benlorenzetti/Potentiostat-Sensor_Interface_Hardware/Report/report.pdf

# Potentiostat Hardware for USB-Style Sensors

Ben Lorenzetti, BioMicroSystems Laboratory

A

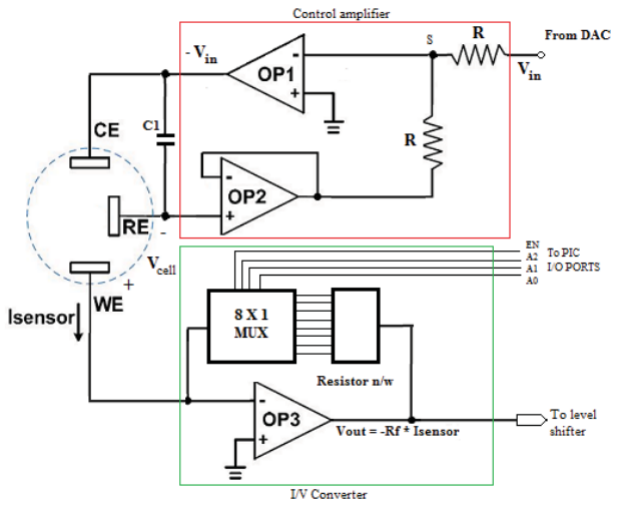
[picture p7: figure]

portable measurement system was assembled using a commercial potentiostat, a custom circuit board, and a 3D-printed enclosure. The system will help demonstrate the portability and simplicity the electrochemical sensors being developed in BioMicroSystems Lab.

## Introduction

BioMicroSystems (BMS) Lab is developing pointof-care electrochemical sensors for measuring heavy metal concentrations in environmental samples, such as manganese in lake water [?].


Figure 1: Measuring Manganese [?]

Three electrodes are inundated in a sample and a potential is applied between two of the electrodes, while a different pair of two electrodes is used to measure current. At some applied voltage, an oxidationreduction reaction occurs between the metal of interest and the working electrode surface. Charge is emitted as the metal changing oxidation state; so measuring and integrating the current gives the quantity of metal reagent in the sample.
In a three electrode system, one electrode must be common to both the voltage pair and the current pair, and this is termed the counter electrode. For the other two electrodes (reference and working) to accurately separate voltage and current, they must be virtually grounded by amplifier electronics. A device which drives the virtual ground, sets a potential, and measures resulting current is called a potentiostat.

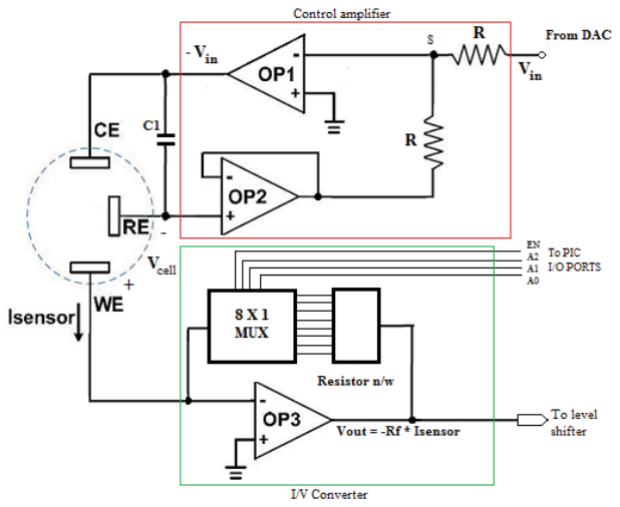
[picture p8: figure]

Figure 2: Op-Amp Potentiostat [?]

The possible advantages of the point-of-care electrodes being developed by BMS Lab include low cost, portability, measurement speed, and simplicity for non-technical operators. To realize these advantages, a small, portable potentiostat is needed with a simple user interface.

(a) EmStat Potentiostat | (b) Pinout Diagram

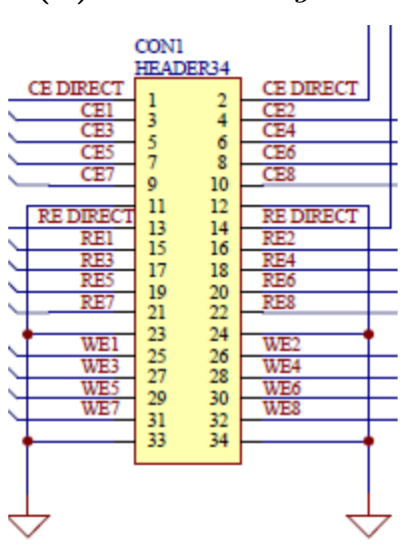
[picture p9: figure]
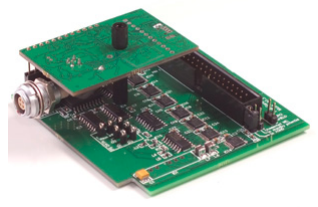
[picture p10: figure]

(c) EmStat with Multiplexer | (d) Pinout Schematic

Figure 3: EmStat and Multiplexer from PalmSens [?]

## Method

An OEM potentiostat board measuring only 2” x 1.35” was purchased from PalmSens, called EmStat. Also from PalmSens, a Multiplexer was purchased that allows EmStat to switch between multiple sensors. The EmStat–Multiplexer connection and the external interface towards the sensors are shown in figure 3.
The external interface from the Multiplexer is a standard 0.1” header but the sensors are made to be inserted into a USB receptacle. To make this simple for the end user, a custom breakout board was made to fit in the space between the EmStat and Multiplexer boards.
The breakout board was designed in CadSoft Eagle and the .brd file was sent to OSH Park LLC for manufacture. The Eagle project and part libraries used can be found in the directory PCB Boards/. In addition to the manufactured board, the components listed in table 2 are need for assembly.

Table 1: Breakout Board Components

Qty. | Component | Man. Part #
4 | USB type-A receptacle | 292303-1
1 | USB mini receptacle | 0548190519
1 | USB mini plug kit | 1734205-1
1 | 34-pin, 0.1” header | SFH11-PBPC-D17-ST-BK
| hookup wire and heat shrink
| for USB plug kit

The x-y coordinates used in aligning the EmStat, Multiplexer, and breakout board are shown in appendix ??. The schematic diagram for the breakout board and a transparent view from Eagle are incluced

(a) Breakout Board | (b) PCB Sandwich...tasty

Figure 4: Breakout Board for EmStat/MUX

in appendix ??.
The packaging was designed in SolidWorks to be 3D-printed in two parts: a base and a lid. In addition to the base and lid, six size #3-48, 1.25” long machine screws and #3-48 tapping equipment are needed for assembly. Instructions for tapping can be found in appendix ??.

Table 2: Assembly Components

Qty. | Component | McMaster Part #
6 | 3-48, 1.25” socket head cap screws | 90044A243
3-48 tap, tap driver, and spring
loaded tap guide | appendix ??

The design of the packaging was tested and iterated in house using a Makerobt Replicator 2X with ABS filament. Mechanical drawings of the base and lid and a list of revisions are included in appendix ??. For printing with MakerBot or an outside printing house, the files Enclosure Base.STL
and | Enclosure Lid.STL | are | needed | from
the Packaging/ directory. | For editing the
parts, the SolidWorks files are located in the Packaging/SolidWorks Files subdirectory.
In addition to the potentiostat system, three small sensor interface boards were built. One allows a USB-style sensor to be extended away from the potentiostat system by a USB male-A-to-male-mini cable. Another allows USB-style sensors to be easily connected to the WaveNow potentiostat. The third allows USB-style sensors to be connected to aligator clips for electroplating, etc.
Designs for these three interface boards are included in appendix ??.

## 1 Results

Sed commodo posuere pede. Mauris ut est. Ut quis purus. Sed ac odio. Sed vehicula hendrerit sem. Duis non odio. Morbi ut dui. Sed accumsan risus eget odio. In hac habitasse platea dictumst. Pellentesque non

Table 3: Random table

Name

First name | Last Name | Grade
John | Doe | 7.5
Richard | Miles | 2

elit. Fusce sed justo eu urna porta tincidunt. Mauris felis odio, sollicitudin sed, volutpat a, ornare ac, erat. Morbi quis dolor. Donec pellentesque, erat ac sagittis semper, nunc dui lobortis purus, quis congue purus metus ultricies tellus. Proin et quam. Class aptent taciti sociosqu ad litora torquent per conubia nostra, per inceptos hymenaeos. Praesent sapien turpis, fermentum vel, eleifend faucibus, vehicula eu, lacus.

## Section 2

Pellentesque habitant morbi tristique senectus et netus et malesuada fames ac turpis egestas. Donec odio elit, dictum in, hendrerit sit amet, egestas sed, leo. Praesent feugiat sapien aliquet odio. Integer vitae justo. Aliquam vestibulum fringilla lorem. Sed neque lectus, consectetuer at, consectetuer sed, eleifend ac, lectus. Nulla facilisi. Pellentesque eget lectus. Proin eu metus. Sed porttitor. In hac habitasse platea dictumst. Suspendisse eu lectus. Ut mi mi, lacinia sit amet, placerat et, mollis vitae, dui. Sed ante tellus, tristique ut, iaculis eu, malesuada ac, dui. Mauris nibh leo, facilisis non, adipiscing quis, ultrices a, dui.

First This is the first item

Last This is the last item

Morbi luctus, wisi viverra faucibus pretium, nibh est placerat odio, nec commodo wisi enim eget quam. Quisque libero justo, consectetuer a, feugiat vitae, porttitor eu, libero. Suspendisse sed mauris vitae elit sollicitudin malesuada. Maecenas ultricies eros sit amet ante. Ut venenatis velit. Maecenas sed mi eget dui varius euismod. Phasellus aliquet volutpat odio. Vestibulum ante ipsum primis in faucibus orci luctus et ultrices posuere cubilia Curae; Pellentesque sit amet pede ac sem eleifend consectetuer. Nullam elementum, urna vel imperdiet sodales, elit ipsum pharetra ligula, ac pretium ante justo a nulla. Curabitur tristique arcu eu metus. Vestibulum lectus. Proin mauris. Proin eu nunc eu urna hendrerit faucibus. Aliquam auctor, pede consequat laoreet varius, eros tellus scelerisque quam, pellentesque hendrerit ipsum dolor sed augue. Nulla nec lacus.

## References

[Figueredo and Wolf, 2009] Figueredo, A. J. and Wolf, P. S. A. (2009). Assortative pairing and life history strategy - a cross-cultural study. Human Nature, 20:317–330.
