benlorenzetti/Potentiostat-Sensor_Interface_Hardware/Report/All_PDFs_to_Merge/top-view.pdf

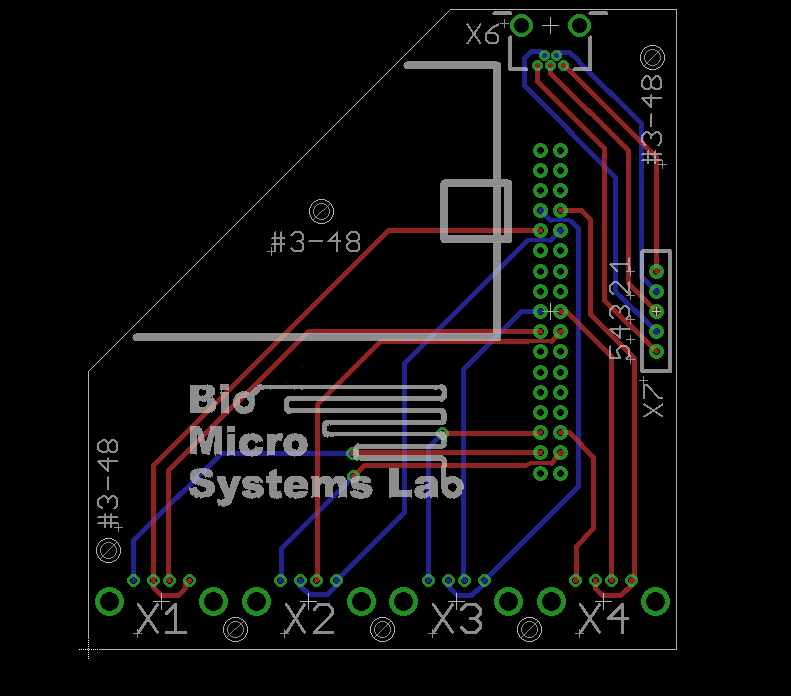
[picture p11: figure]

Transparent, top-side view of Breakout Board
