benlorenzetti/Potentiostat-Sensor_Interface_Hardware/Report/All_PDFs_to_Merge/2015-04-14-Enclosure-Base.pdf

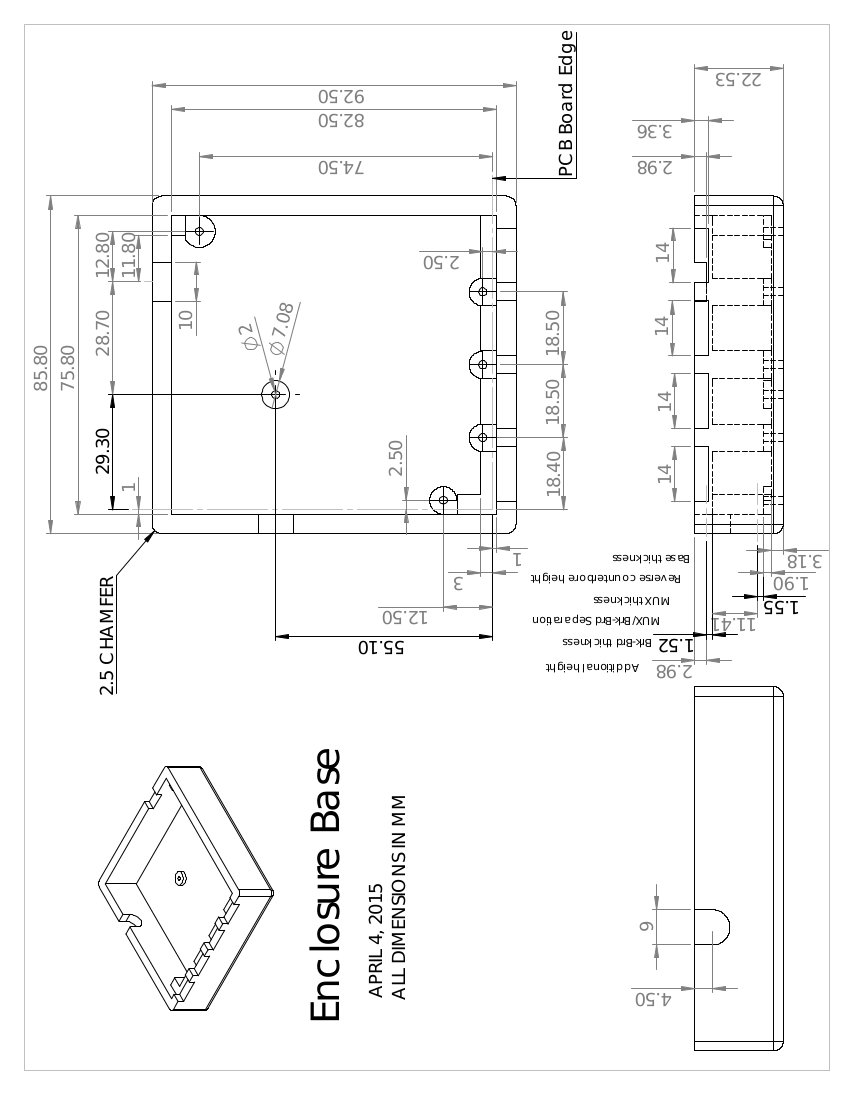
[picture p12: page 1]
