benlorenzetti/Potentiostat-Sensor_Interface_Hardware/Report/Figures/sensor-enclosure-bottom.pdf

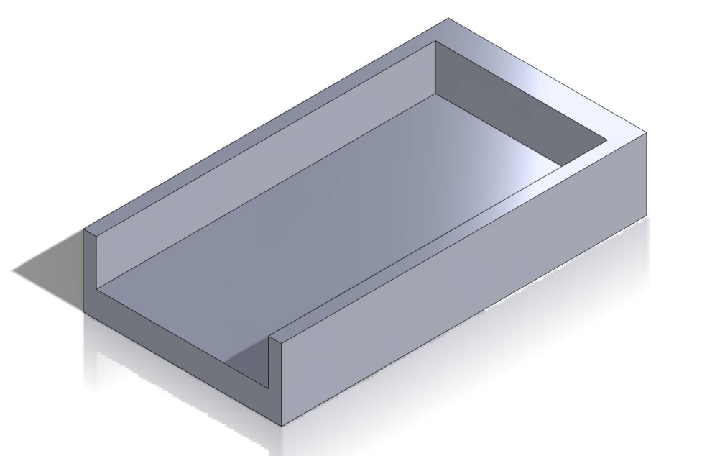
[picture p13: page 1]
