benlorenzetti/Potentiostat-Sensor_Interface_Hardware/Report/Figures/sensor-enclosure-top.pdf

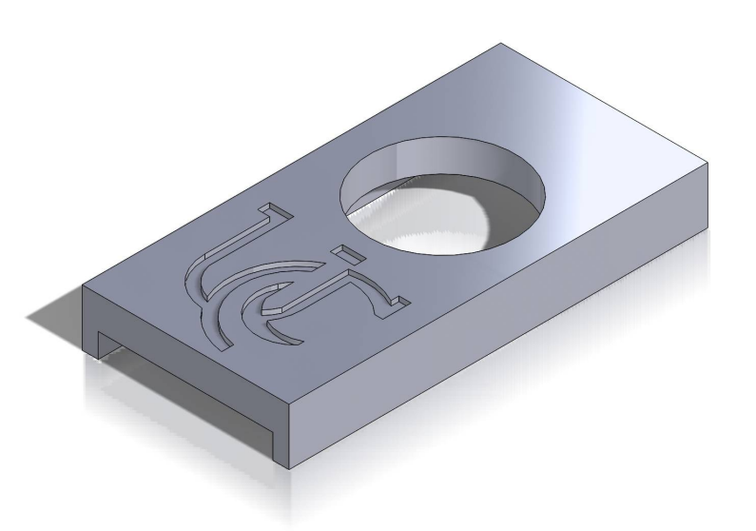
[picture p14: page 1]
