benlorenzetti/Potentiostat-Sensor_Interface_Hardware/Report/Figures/breakout-board.pdf

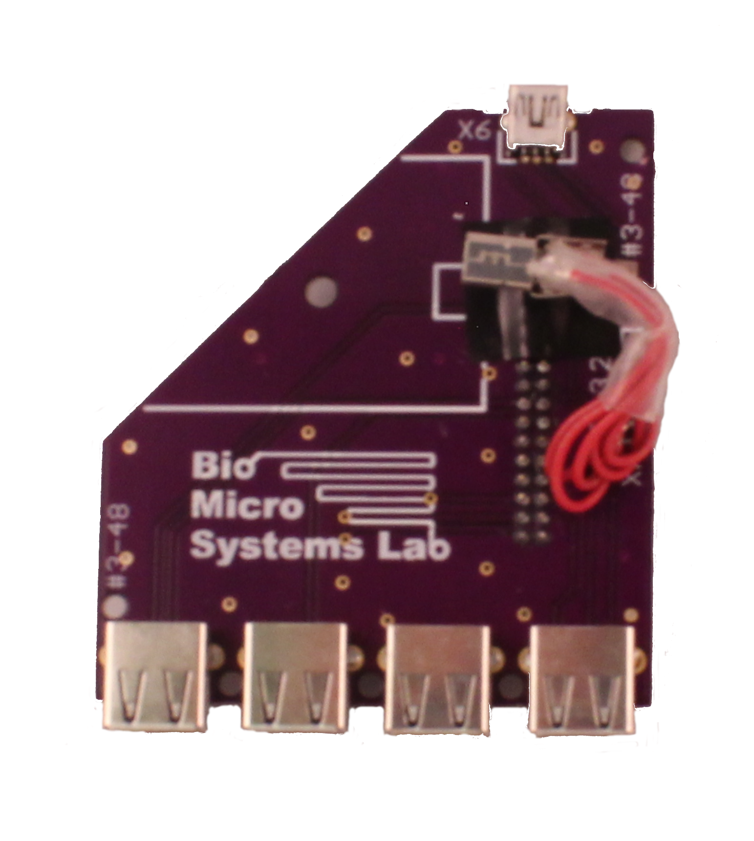
[picture p15: page 1]
