benlorenzetti/Potentiostat-Sensor_Interface_Hardware/Report/Figures/interface-board.pdf

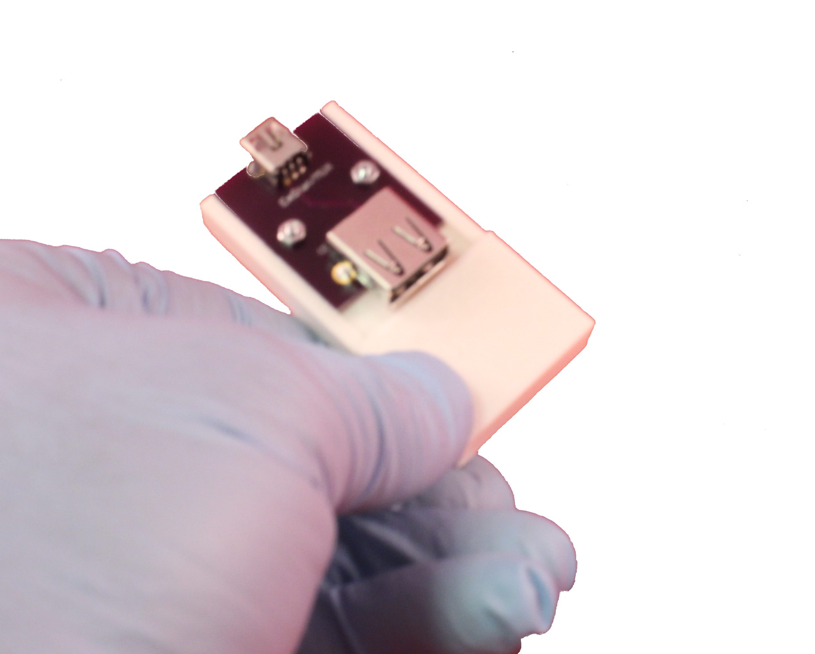
[picture p16: page 1]
