benlorenzetti/Potentiostat-Sensor_Interface_Hardware/Report/Figures/packaging-comparison.pdf

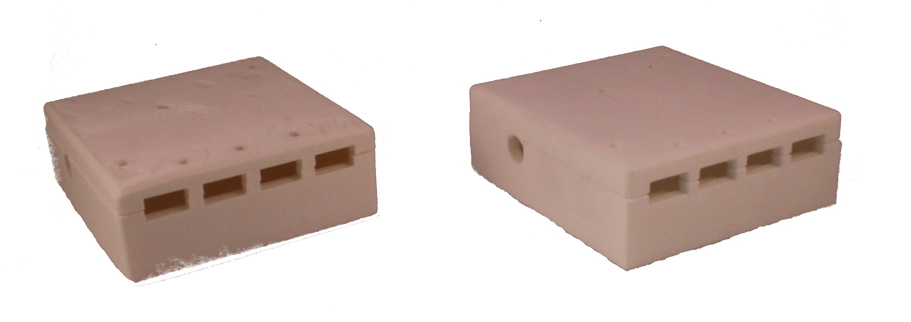
[picture p17: page 1]
