benlorenzetti/Potentiostat-Sensor_Interface_Hardware/Report/Figures/tap-location-drawing.pdf

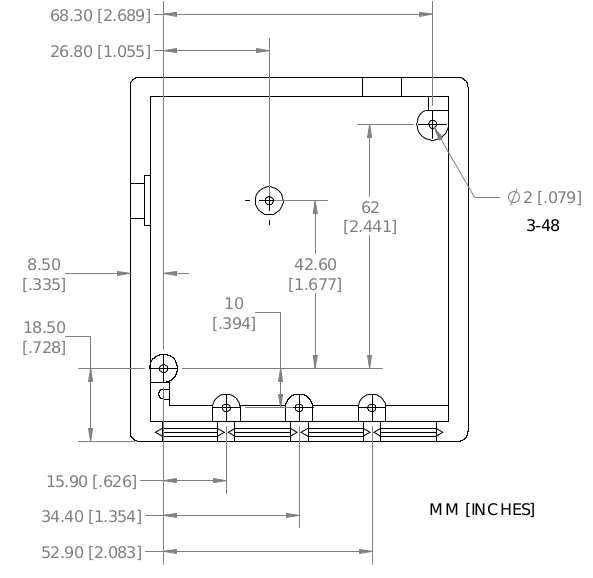
[picture p18: page 1]
