benlorenzetti/Potentiostat-Sensor_Interface_Hardware/Report/Figures/zinc-paper-potentiostat.pdf

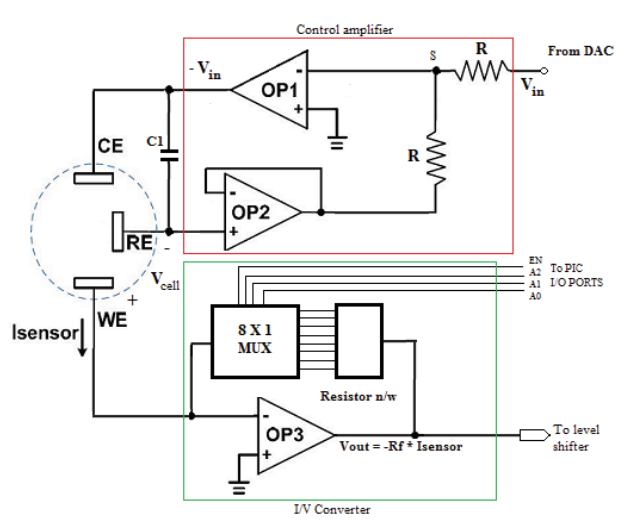
[picture p19: page 1]
