benlorenzetti/Potentiostat-Sensor_Interface_Hardware/Report/Figures/setting_eagle_directories.png

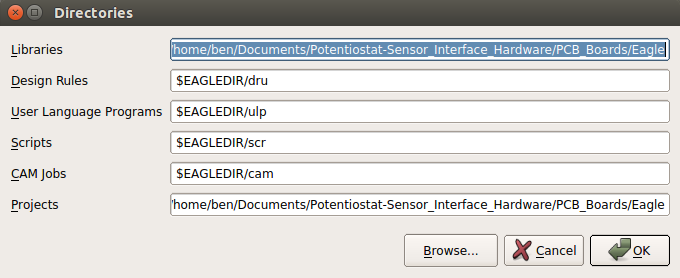
Report/Figures/setting_eagle_directories.png
