benlorenzetti/Potentiostat-Sensor_Interface_Hardware/Report/Figures/tapping.jpg

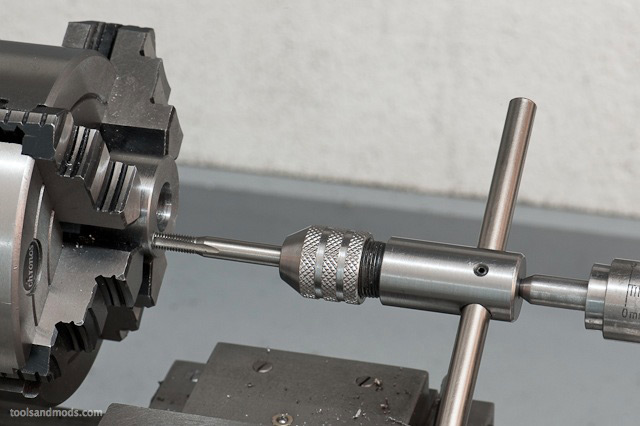
Report/Figures/tapping.jpg
