benlorenzetti/Potentiostat-Sensor_Interface_Hardware/Report/Photos/IMG_0366.JPG

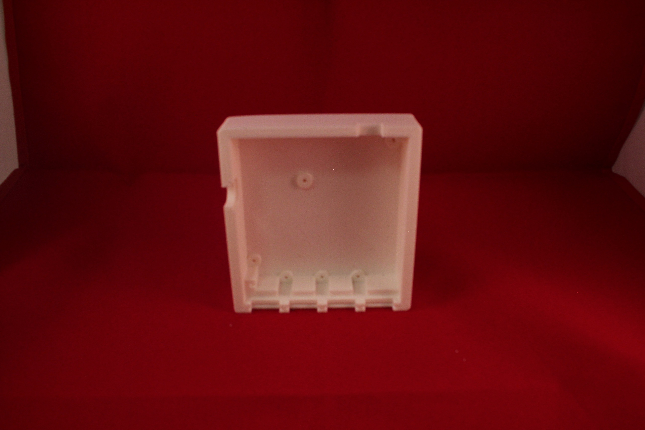
Report/Photos/IMG_0366.JPG
