benlorenzetti/Potentiostat-Sensor_Interface_Hardware/Report/Photos/IMG_0367.JPG

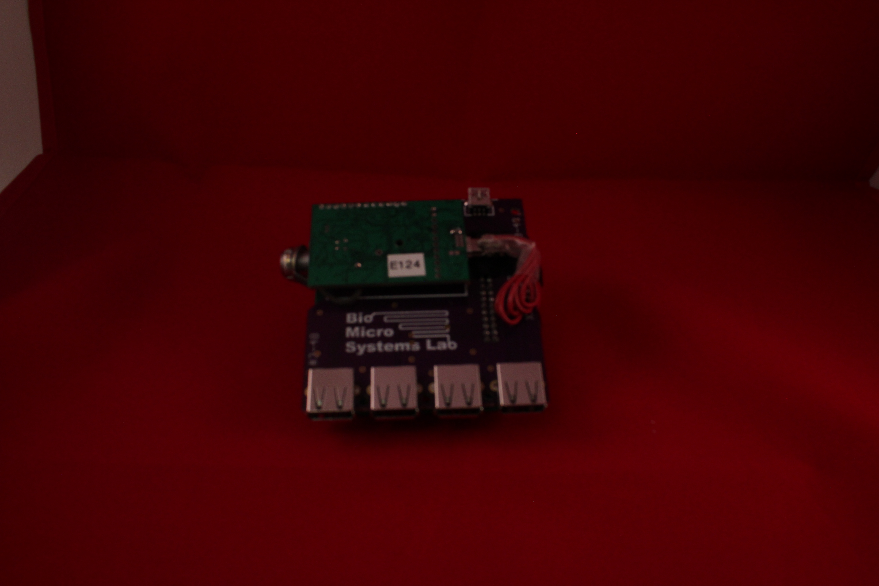
Report/Photos/IMG_0367.JPG
