benlorenzetti/Potentiostat-Sensor_Interface_Hardware/Report/Photos/IMG_0368.JPG

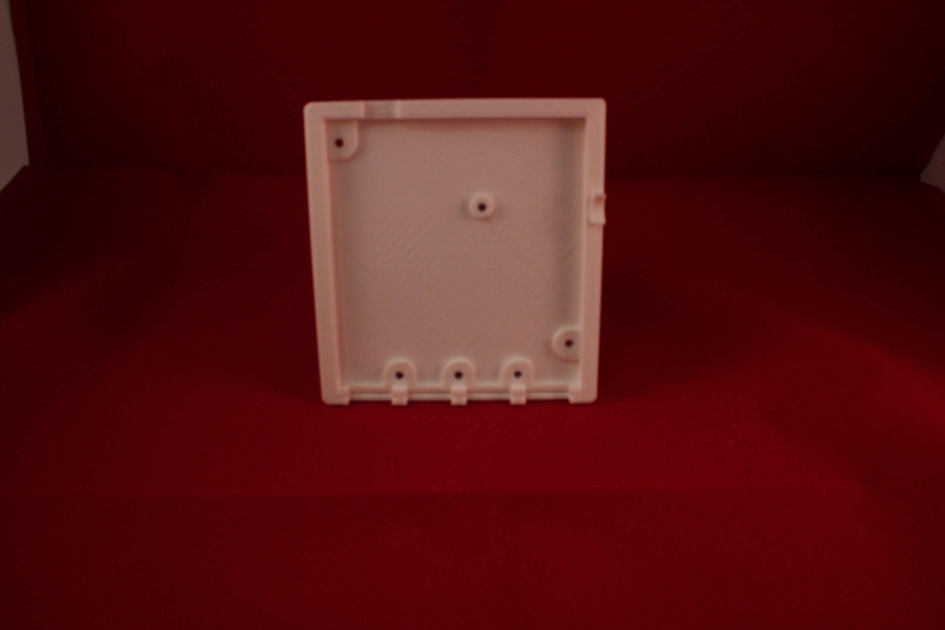
Report/Photos/IMG_0368.JPG
