benlorenzetti/Potentiostat-Sensor_Interface_Hardware/Report/Photos/IMG_0369.JPG

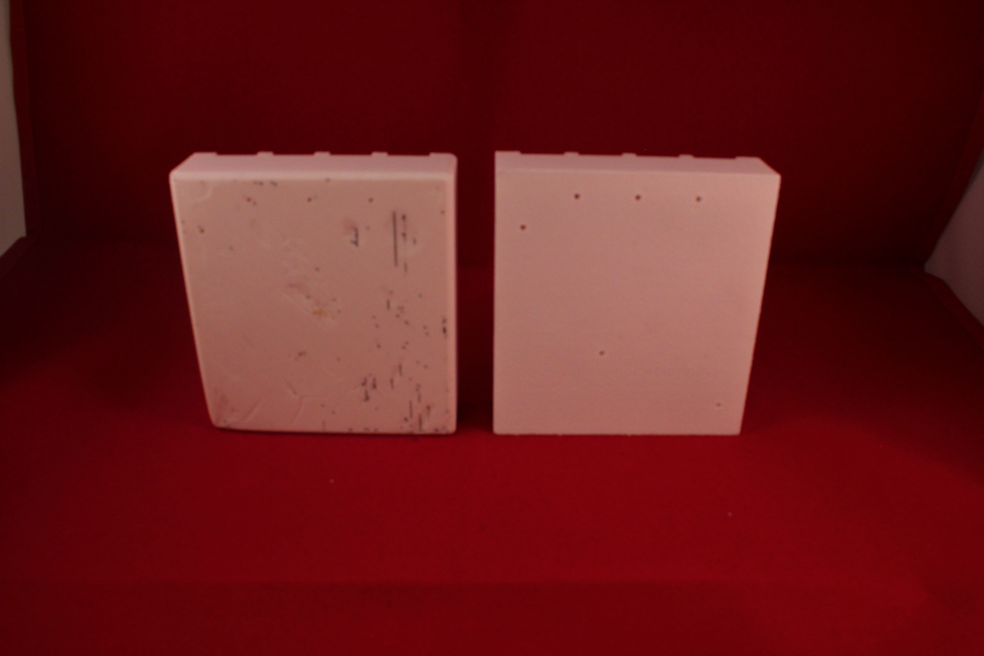
Report/Photos/IMG_0369.JPG
