benlorenzetti/Potentiostat-Sensor_Interface_Hardware/Packaging/Enclosure_Lid.STL

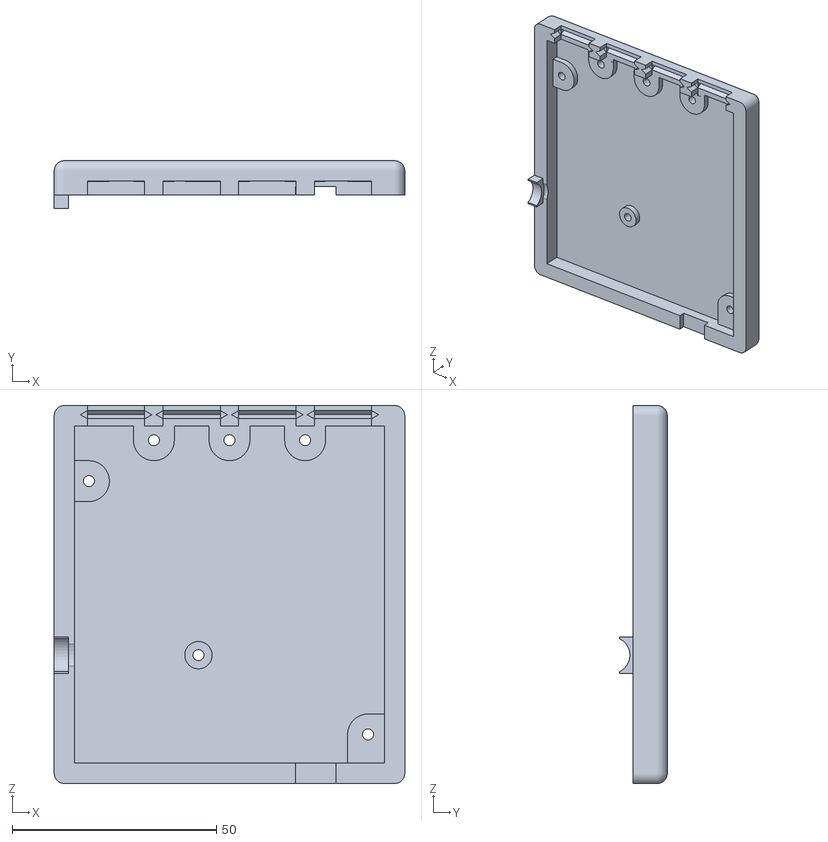
[picture p26: CAD file, 2015-05-11]
Packaging/Enclosure_Lid.STL
85.8 x 11.7 x 92.5
