benlorenzetti/Potentiostat-Sensor_Interface_Hardware/Packaging/SolidWorks_Files/Sensor_Enclosure_Top.SLDPRT

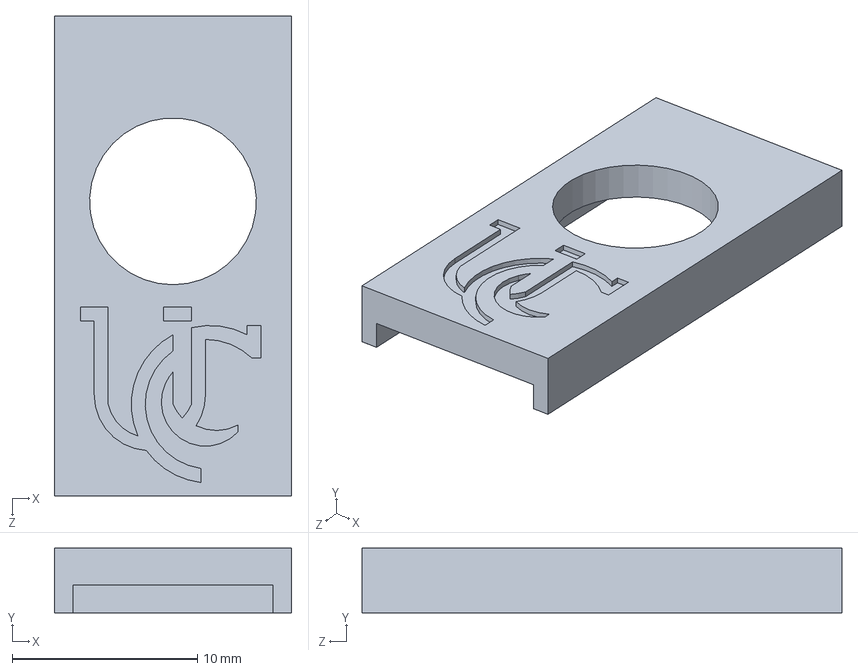
[picture p27: CAD file, 2015-05-11]
Packaging/SolidWorks_Files/Sensor_Enclosure_Top.SLDPRT
12.8 x 3.50 x 25.9 mm
