benlorenzetti/Potentiostat-Sensor_Interface_Hardware/Packaging/SolidWorks_Files/Sensor_Enclosure_Bottom.SLDPRT

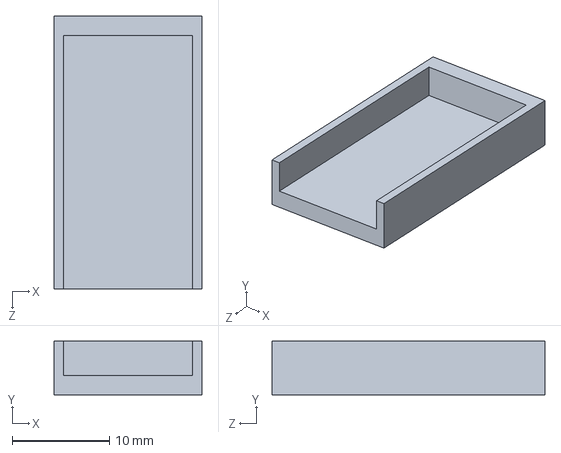
[picture p28: CAD file, 2015-05-11]
Packaging/SolidWorks_Files/Sensor_Enclosure_Bottom.SLDPRT
15.2 x 5.50 x 28.0 mm
