benlorenzetti/Potentiostat-Sensor_Interface_Hardware/Packaging/SolidWorks_Files/2015-05-06-Enclosure-Base.SLDPRT

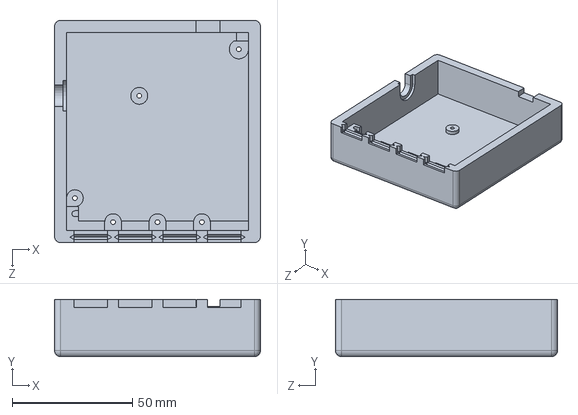
[picture p29: CAD file, 2015-05-08]
Packaging/SolidWorks_Files/2015-05-06-Enclosure-Base.SLDPRT
85.8 x 23.8 x 92.5 mm
