benlorenzetti/Potentiostat-Sensor_Interface_Hardware/Packaging/SolidWorks_Files/enclosure-base.SLDPRT

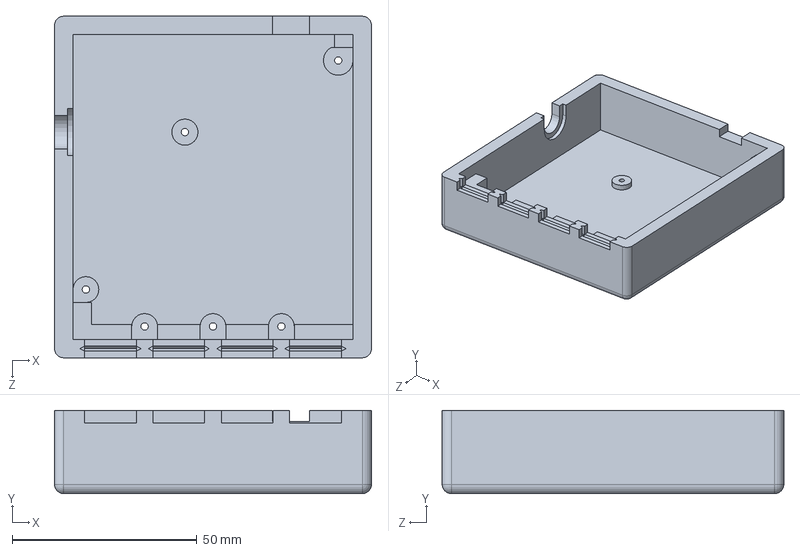
[picture p30: CAD file, 2015-05-08]
Packaging/SolidWorks_Files/enclosure-base.SLDPRT
85.8 x 22.5 x 92.5 mm
