benlorenzetti/Potentiostat-Sensor_Interface_Hardware/Packaging/SolidWorks_Files/2015-05-06-Sensor-Interface.SLDPRT

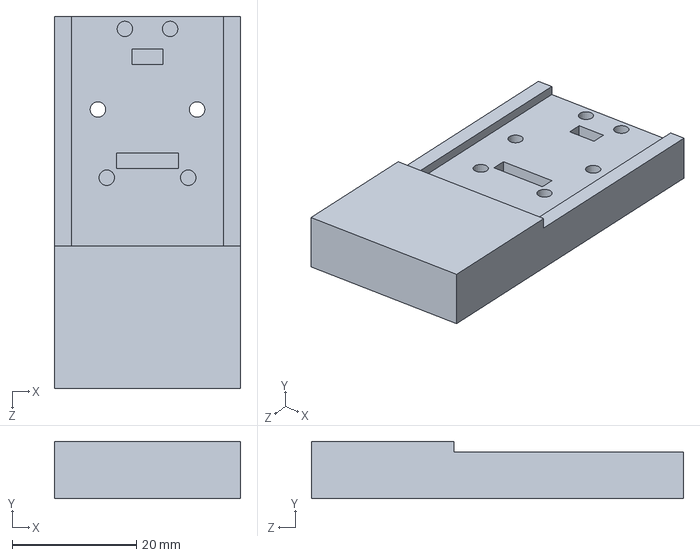
[picture p31: CAD file, 2015-05-08]
Packaging/SolidWorks_Files/2015-05-06-Sensor-Interface.SLDPRT
30.0 x 9.25 x 60.0 mm
