benlorenzetti/Potentiostat-Sensor_Interface_Hardware/Packaging/SolidWorks_Files/2015-04-29-Enclosure-Lid.SLDPRT

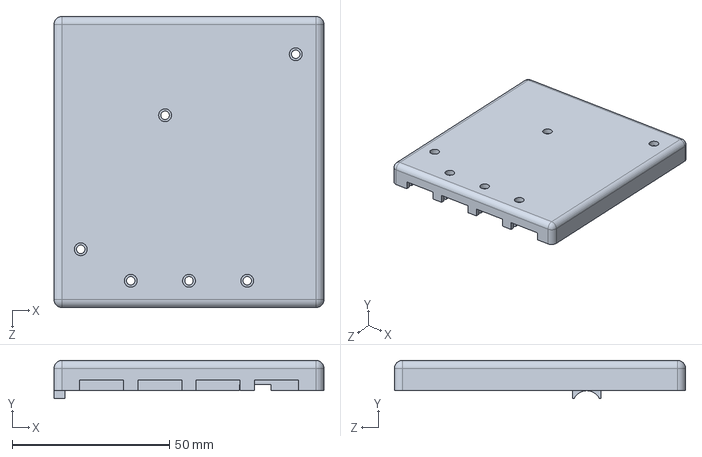
[picture p32: CAD file, 2015-05-08]
Packaging/SolidWorks_Files/2015-04-29-Enclosure-Lid.SLDPRT
85.8 x 12.1 x 92.5 mm
