benlorenzetti/Potentiostat-Sensor_Interface_Hardware/(list of files, cad)

Other CAD files:
Packaging/SolidWorks_Files/2015-05-06-Enclosure-Lid.SLDPRT
Packaging/SolidWorks_Files/2015-04-04-Enclosure-Lid.SLDPRT
Packaging/SolidWorks_Files/2015-04-04-Enclosure-Base.SLDPRT
Packaging/SolidWorks_Files/2015-04-29-Enclosure-Base.SLDPRT
Packaging/Enclosure_Base.STL
Packaging/SolidWorks_Files/2015-05-06-Sensor-Interface.STL
Packaging/SolidWorks_Files/Sensor_Enclosure_Bottom.STL
Packaging/SolidWorks_Files/Sensor_Enclosure_Top.STL
