benlorenzetti/Potentiostat-Sensor_Interface_Hardware/Report/Figures/complete-assembly.pdf

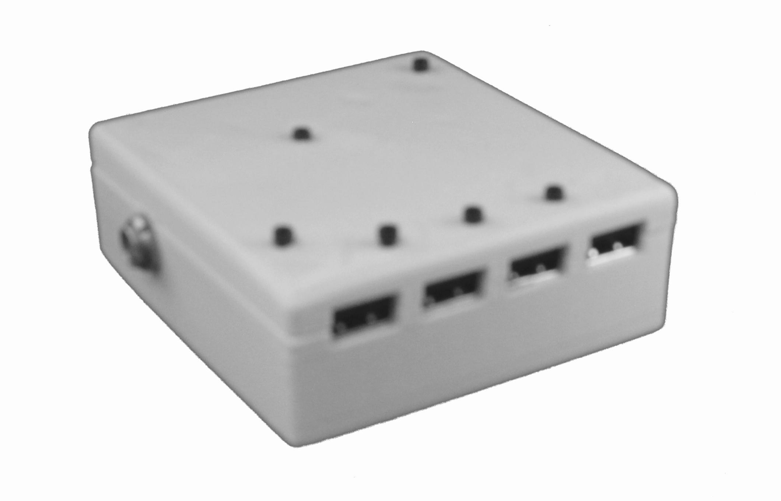
[picture p33: page 1]
