benlorenzetti/Potentiostat-Sensor_Interface_Hardware/Report/All_PDFs_to_Merge/2015-04-29-Change-Log.pdf

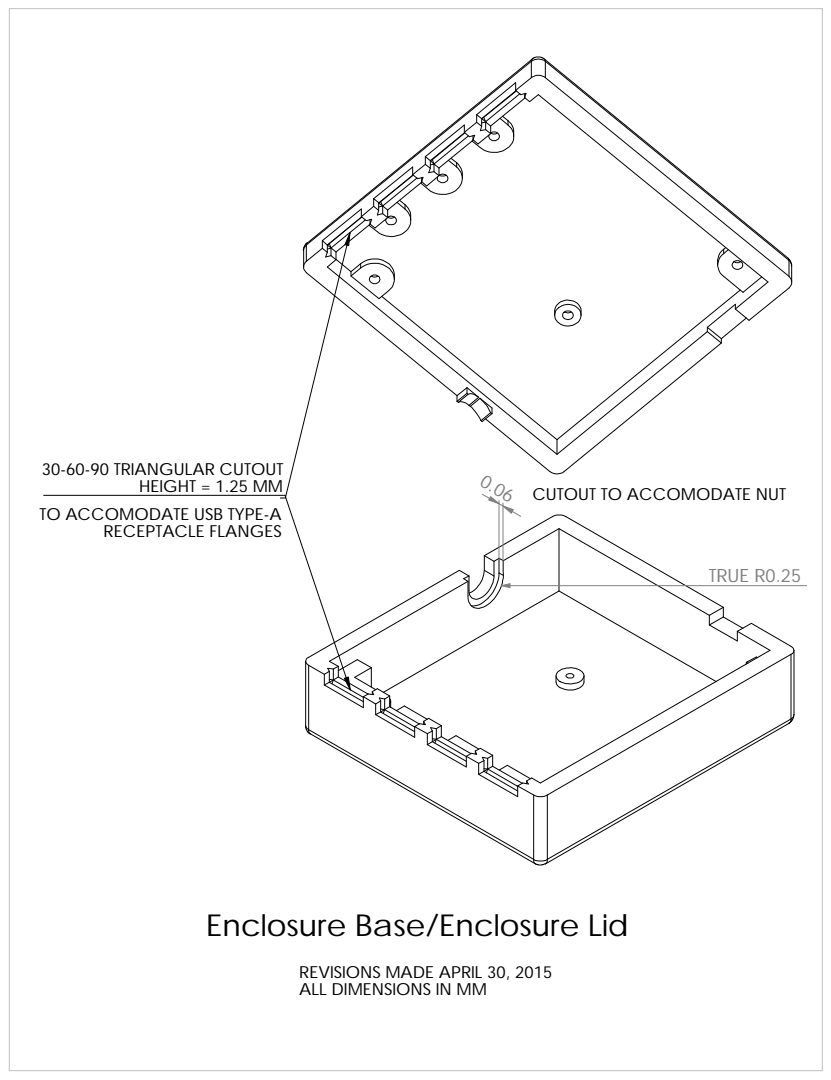
[picture p34: page 1]
RECEPTACLE FLANGES; 30-60-90 TRIANGULAR CUTOUT; HEIGHT = 1.25 MM; CUTOUT TO ACCOMODATE NUT 0.06; TRUE R0.25

TO ACCOMODATE USB TYPE-A

Enclosure Base/Enclosure Lid

REVISIONS MADE APRIL 30, 2015
ALL DIMENSIONS IN MM
