benlorenzetti/Potentiostat-Sensor_Interface_Hardware/Report/All_PDFs_to_Merge/2015-05-06-Base-Change-Log.pdf

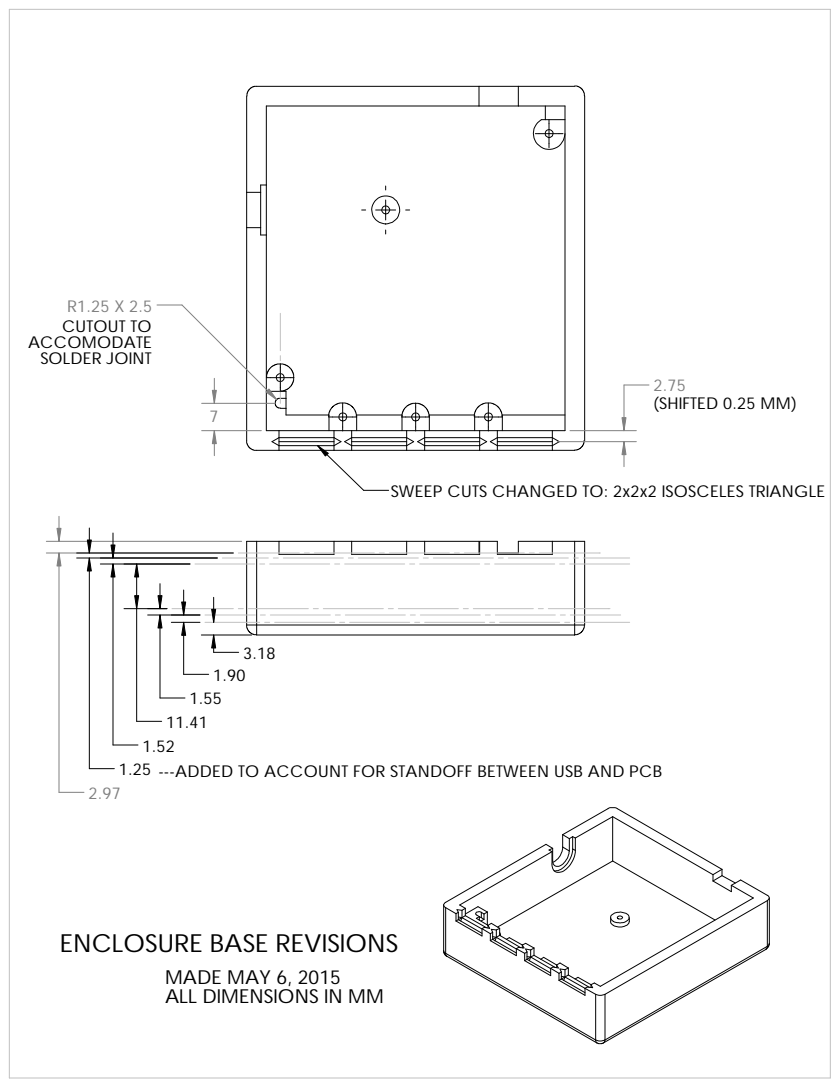
[picture p35: page 1]
CUTOUT TO ACCOMODATE SOLDER JOINT; ---ADDED TO ACCOUNT FOR STANDOFF BETWEEN USB AND PCB; (SHIFTED 0.25 MM)

SWEEP CUTS CHANGED TO: 2x2x2 ISOSCELES TRIANGLE

ENCLOSURE BASE REVISIONS

MADE MAY 6, 2015
ALL DIMENSIONS IN MM
