benlorenzetti/Potentiostat-Sensor_Interface_Hardware/Report/All_PDFs_to_Merge/2015-05-06-Lid-Change-Log.pdf

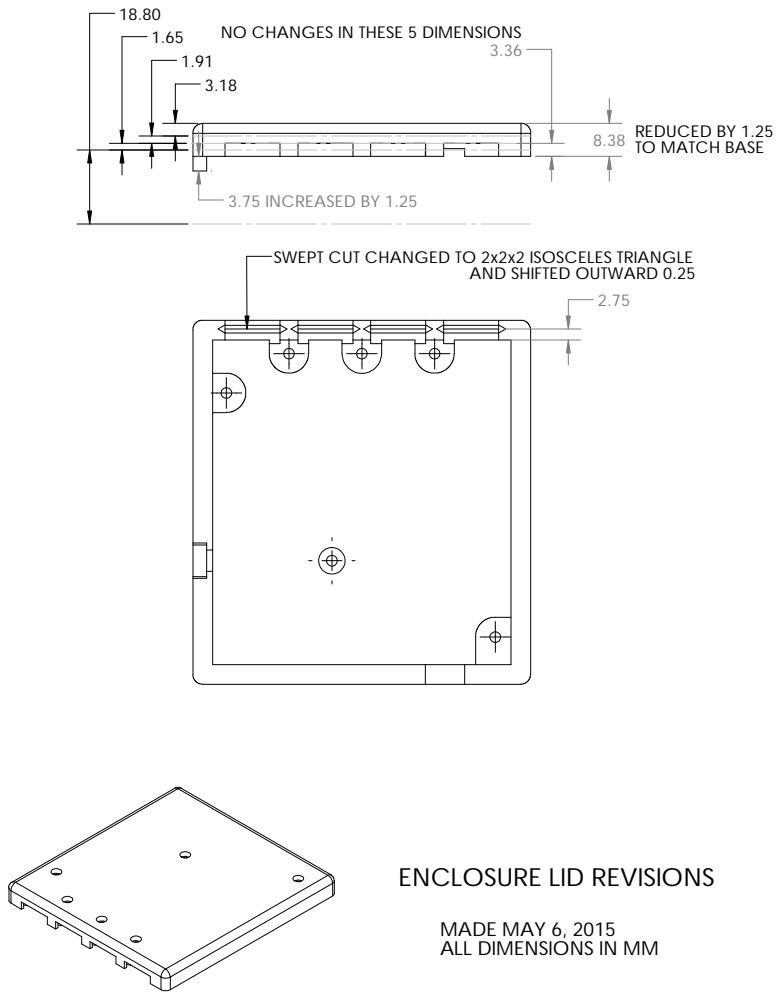
[picture p36: page 1]
3.75 INCREASED BY 1.25

NO CHANGES IN THESE 5 DIMENSIONS

REDUCED BY 1.25
TO MATCH BASE 8.38

SWEPT CUT CHANGED TO 2x2x2 ISOSCELES TRIANGLE

AND SHIFTED OUTWARD 0.25

ENCLOSURE LID REVISIONS

MADE MAY 6, 2015
ALL DIMENSIONS IN MM
