benlorenzetti/Potentiostat-Sensor_Interface_Hardware/Report/All_PDFs_to_Merge/2015-04-06-XY-Drawing.pdf

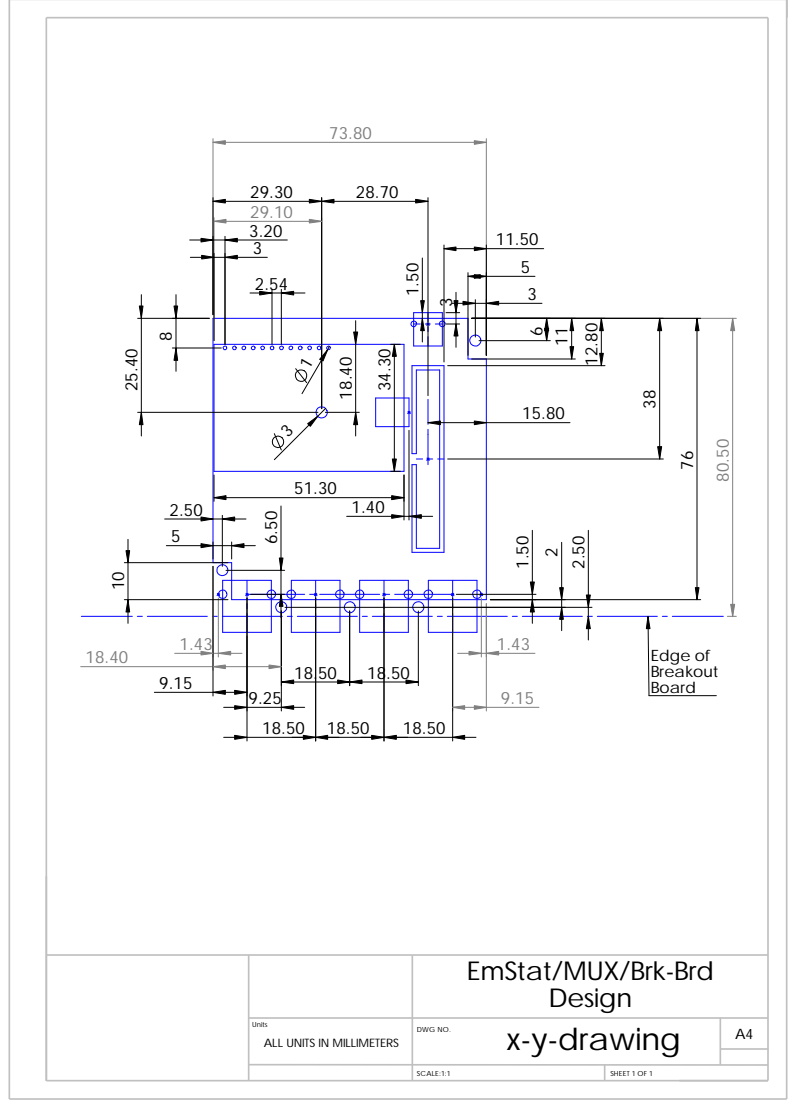
[picture p37: page 1]
SCALE:1:1; SHEET 1 OF 1; Edge of Breakout Board

29.10
3.20

EmStat/MUX/Brk-Brd Design

Units ALL UNITS IN MILLIMETERS | DWG NO. x-y-drawing | A4
