benlorenzetti/Potentiostat-Sensor_Interface_Hardware/Report/All_PDFs_to_Merge/2015-04-14-Enclosure-Lid.pdf

# Enclosure Lid

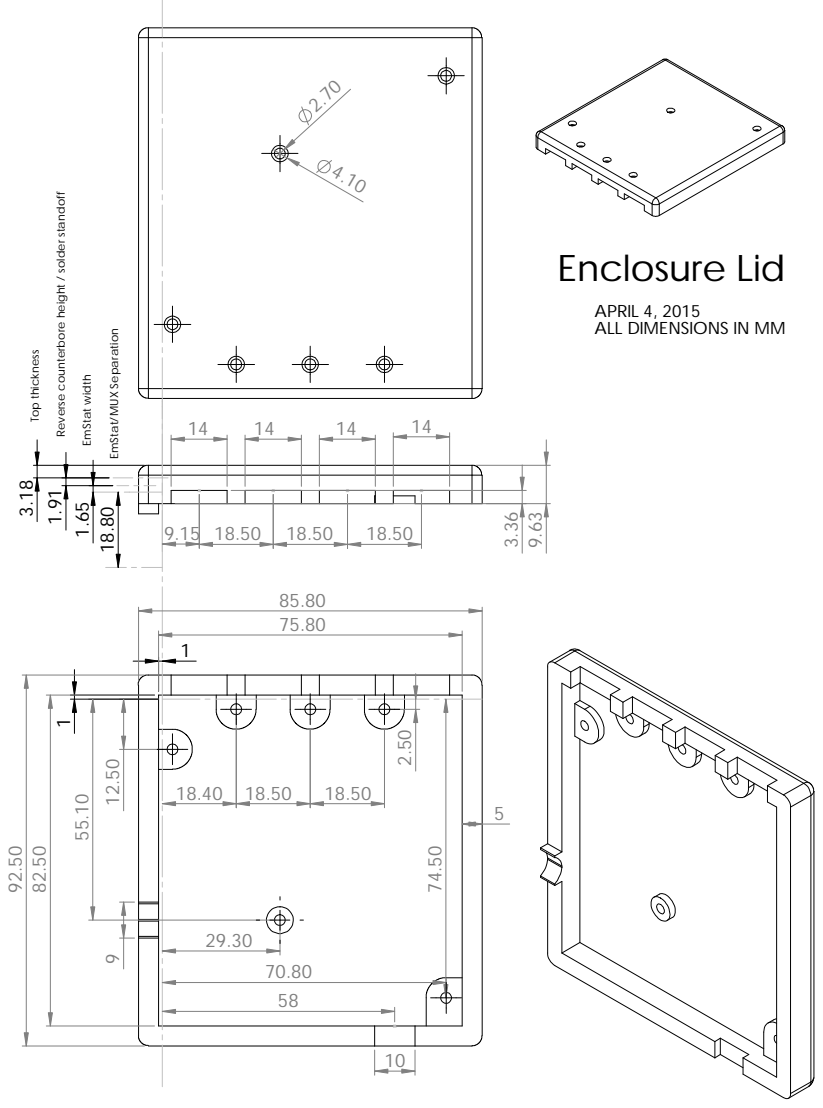
[picture p38: page 1]
Top thickness; EmStat width

Reverse counterbore height / solder standoff

APRIL 4, 2015
ALL DIMENSIONS IN MM

EmStat/MUX Separation
