benlorenzetti/Potentiostat-Sensor_Interface_Hardware/Report/All_PDFs_to_Merge/2015-05-04-Sensor-Interface.pdf

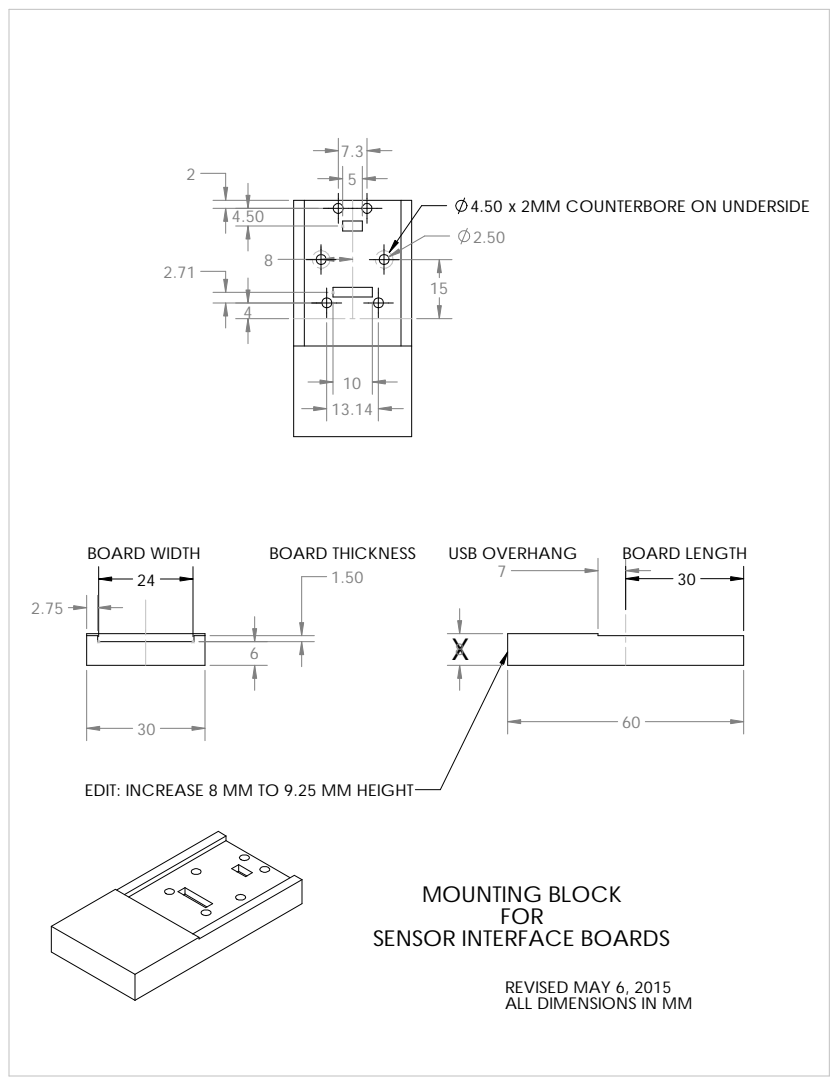
[picture p39: page 1]
FOR; MOUNTING BLOCK; BOARD WIDTH; BOARD THICKNESS; USB OVERHANG; BOARD LENGTH

x 2MM COUNTERBORE ON UNDERSIDE

EDIT: INCREASE 8 MM TO 9.25 MM HEIGHT

SENSOR INTERFACE BOARDS

REVISED MAY 6, 2015
ALL DIMENSIONS IN MM
