benlorenzetti/Potentiostat-Sensor_Interface_Hardware/Packaging/Drawings/2015-05-06-Base-Tapping-Locations.pdf

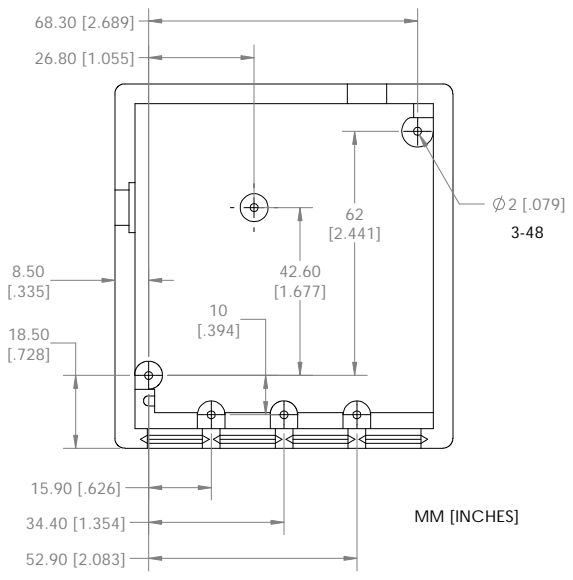
[picture p40: page 1]
MM [INCHES]
