benlorenzetti/Potentiostat-Sensor_Interface_Hardware/(commit log)

2015-05-08 eagle files, print files, and introduction
    [2015-04-04-Enclosure-Base.SLDPRT, 2015-04-04-Enclosure-Lid.SLDPRT, 2015-04-29-Enclosure-Base.SLDPRT, 2015-04-29-Enclosure-Lid.SLDPRT, 2015-05-04-Sensor-Interface.SLDPRT, 2015-05-06-Enclosure-Base.SLDPRT, 2015-05-06-Enclosure-Lid.SLDPRT, 2015-05-06-Sensor-Interface.SLDPRT]
2015-05-11 final editing done
    [2015-05-04-Sensor-Interface.SLDPRT, 2015-05-06-Enclosure-Lid.SLDPRT, 2015-05-06-Enclosure-Lid.STL, 2015-05-06-Sensor-Interface.STL, Enclosure_Lid.STL, Sensor_Enclosure_Bottom.SLDPRT, Sensor_Enclosure_Bottom.STL, Sensor_Enclosure_Top.SLDPRT]
